jonahdeclerck/swashplateless_helicopter/README.md

A Swashplateless Helicopter Design Inspired by [this video by Tom Stanton](https://youtu.be/d80oXSCcHTk?si=MYQpmtHN8eGi8ZL7) 

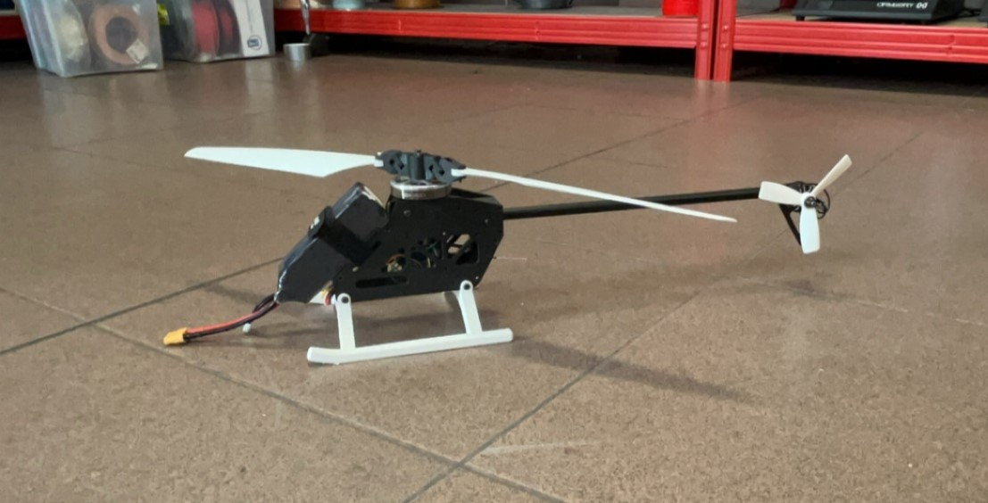
[picture p1: img/swashplateless.jpg]
swashplateless helicopter
