jonahdeclerck/swashplateless_helicopter/3d-files/rotorhead/v4/arm.stl

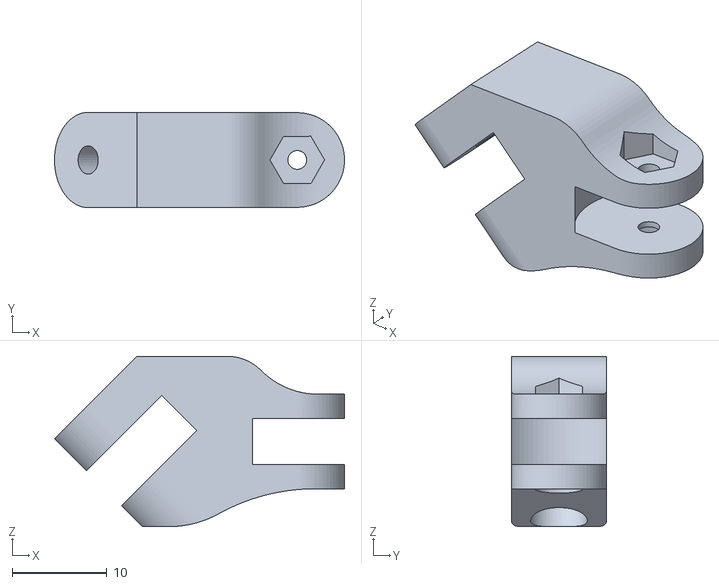
[picture p31: CAD file, 2024-05-28]
3d-files/rotorhead/v4/arm.stl
30.6 x 10.0 x 18.0
