jonahdeclerck/swashplateless_helicopter/3d-files/side-plate-v2.stl

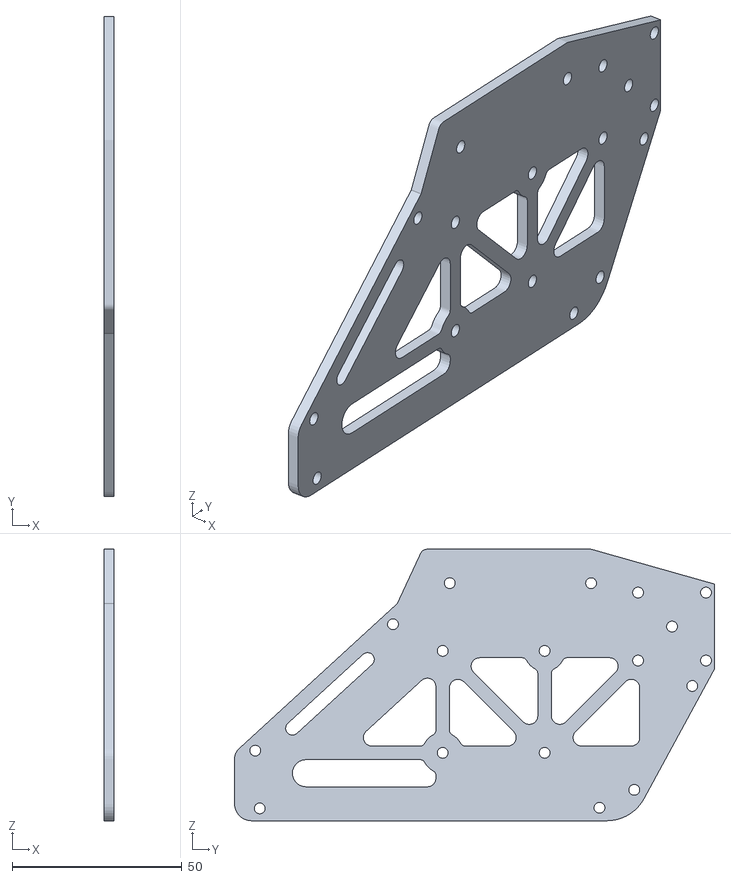
[picture p32: CAD file, 2024-05-28]
3d-files/side-plate-v2.stl
3.00 x 141.3 x 79.9
