jonahdeclerck/swashplateless_helicopter/3d-files/stack-mount/stack-mount-v2.stl

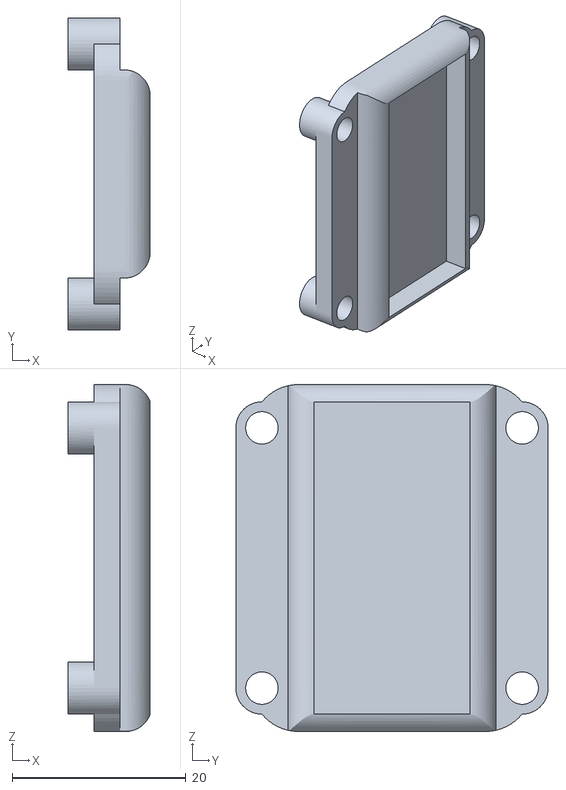
[picture p33: CAD file, 2024-05-28]
3d-files/stack-mount/stack-mount-v2.stl
9.50 x 36.0 x 40.0
