jonahdeclerck/swashplateless_helicopter/3d-files/tailboom/tailboom-block/tailboom-block-v2.stl

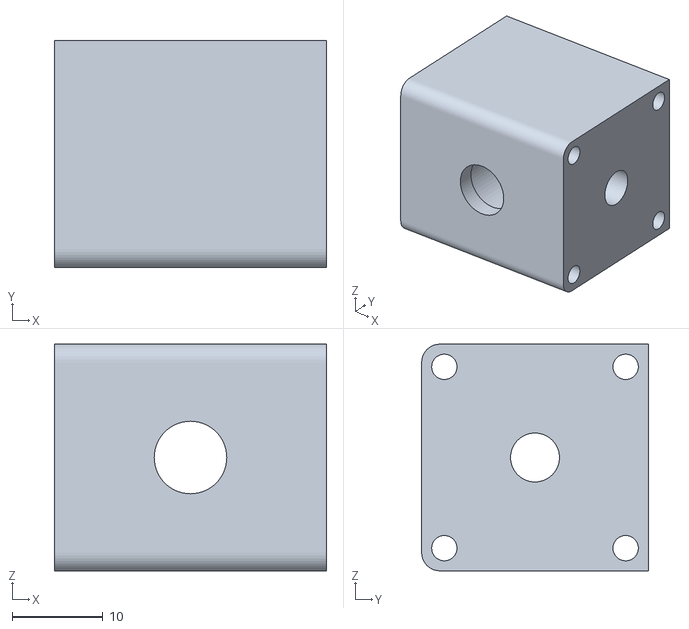
[picture p34: CAD file, 2024-05-28]
3d-files/tailboom/tailboom-block/tailboom-block-v2.stl
30.0 x 25.0 x 25.0
