jonahdeclerck/swashplateless_helicopter/3d-files/tailboom/tailboom-motor-mount/v3/tailboom-motor-mount-v3.stl

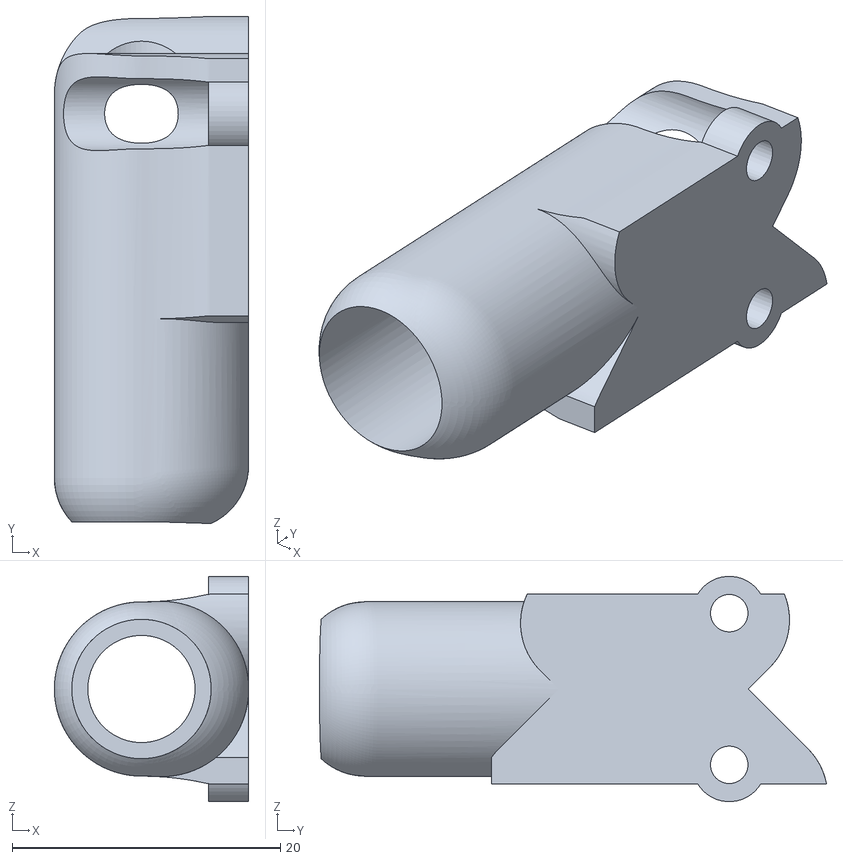
[picture p35: CAD file, 2024-05-28]
3d-files/tailboom/tailboom-motor-mount/v3/tailboom-motor-mount-v3.stl
14.5 x 37.8 x 16.8
