jonahdeclerck/swashplateless_helicopter/3d-files/top-plate/v5/top.stl

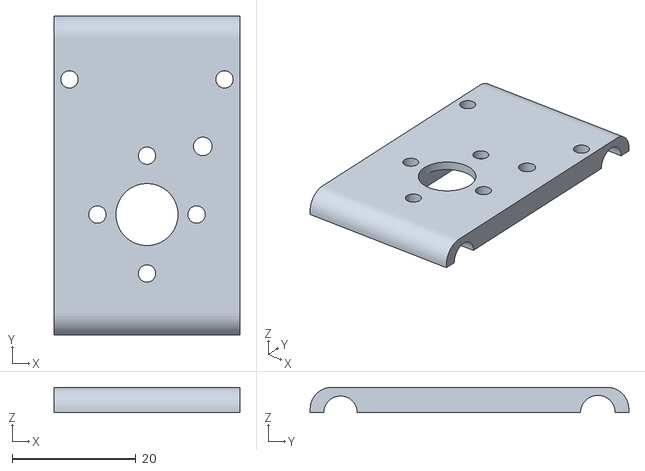
[picture p36: CAD file, 2024-05-28]
3d-files/top-plate/v5/top.stl
30.0 x 51.4 x 4.10
