jonahdeclerck/swashplateless_helicopter/3d-files/rotorhead/v5 (bearings)/hub.stl

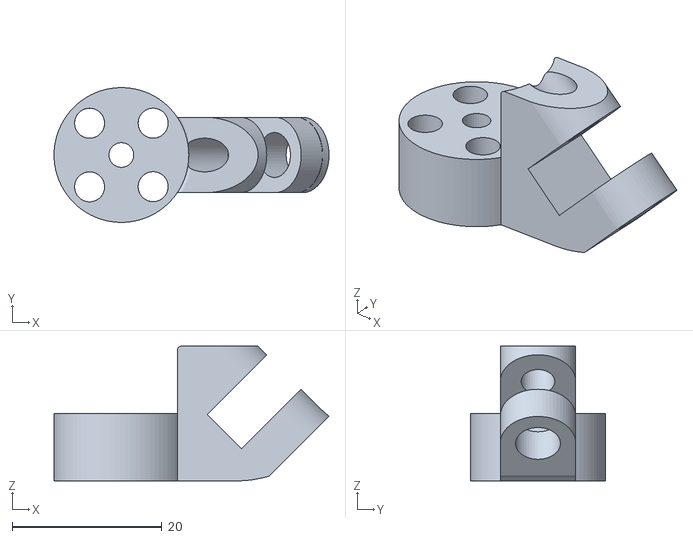
[picture p37: CAD file, 2024-05-28]
3d-files/rotorhead/v5 (bearings)/hub.stl
36.7 x 18.0 x 18.0
