jonahdeclerck/swashplateless_helicopter/3d-files/top-plate/v5/bottom.stl

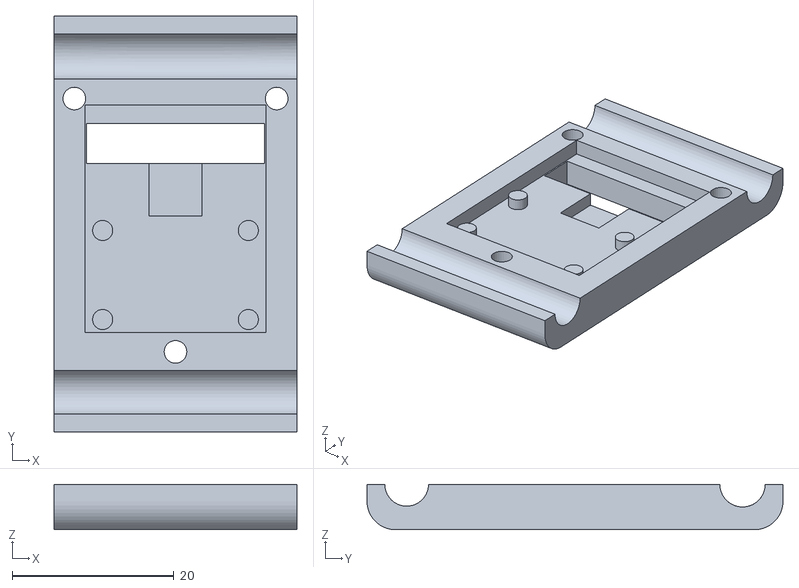
[picture p38: CAD file, 2024-05-28]
3d-files/top-plate/v5/bottom.stl
30.0 x 51.4 x 5.60
