jonahdeclerck/swashplateless_helicopter/3d-files/skids-v1.stl

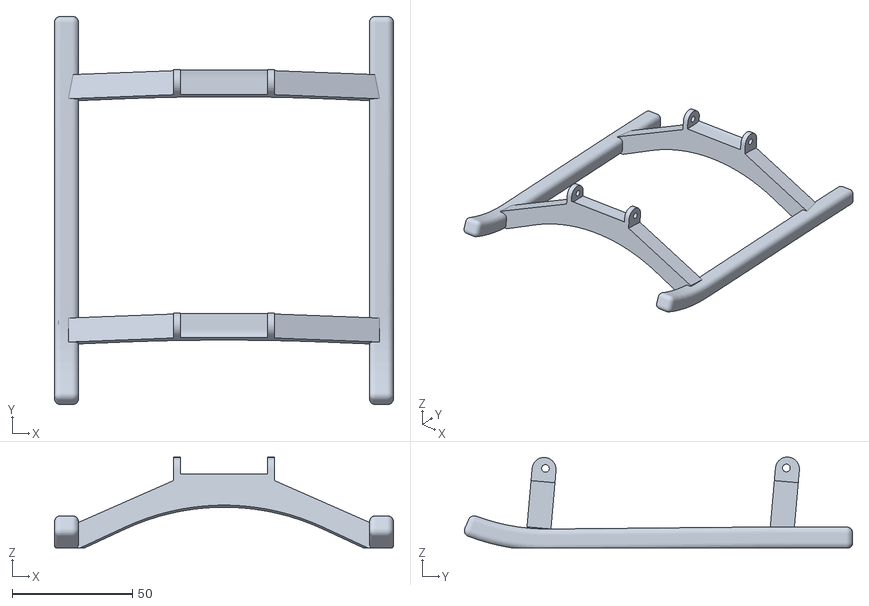
[picture p39: CAD file, 2024-05-28]
3d-files/skids-v1.stl
140.7 x 161.2 x 37.7
