jonahdeclerck/swashplateless_helicopter/3d-files/rear-plate-v1.stl

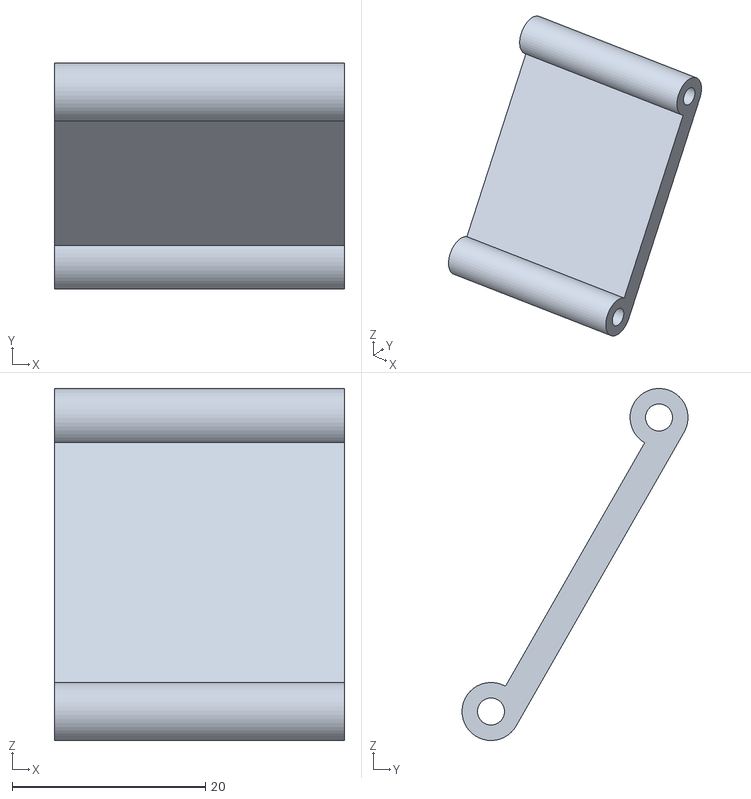
[picture p40: CAD file, 2024-05-28]
3d-files/rear-plate-v1.stl
30.0 x 23.4 x 36.4
