jonahdeclerck/swashplateless_helicopter/3d-files/bottom-plate-v1.stl

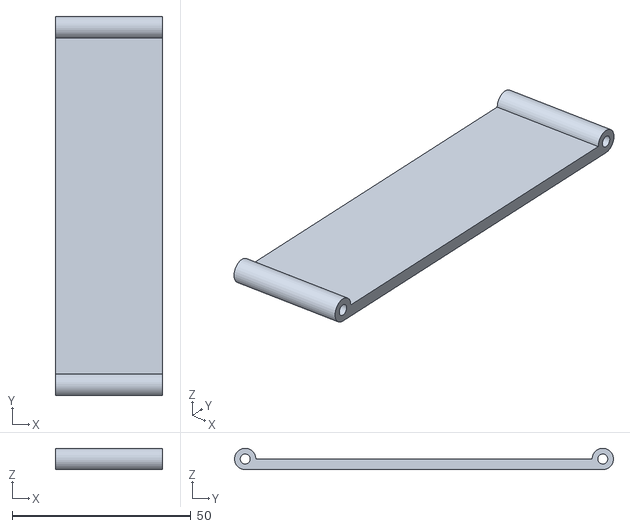
[picture p41: CAD file, 2024-05-28]
3d-files/bottom-plate-v1.stl
30.0 x 106.0 x 5.99
