jonahdeclerck/swashplateless_helicopter/3d-files/front-plate-v4.stl

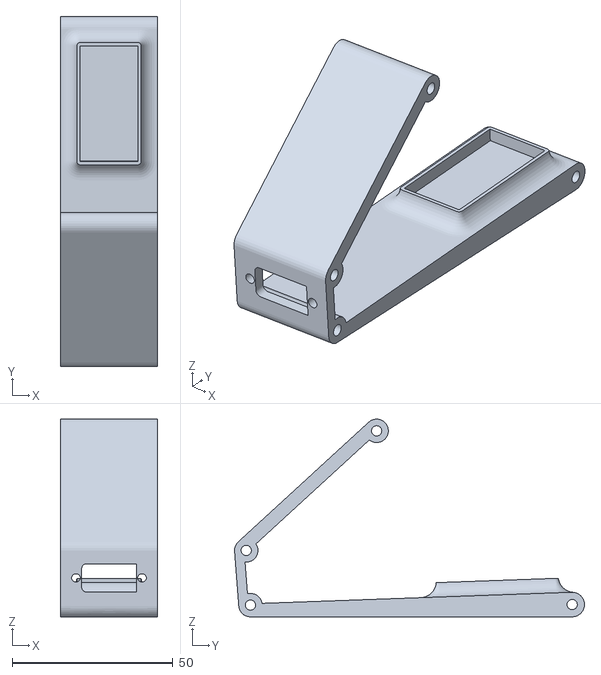
[picture p42: CAD file, 2024-05-28]
3d-files/front-plate-v4.stl
30.0 x 108.8 x 61.5
