jonahdeclerck/swashplateless_helicopter/3d-files/rear-plate-v2-tracer_rx.stl

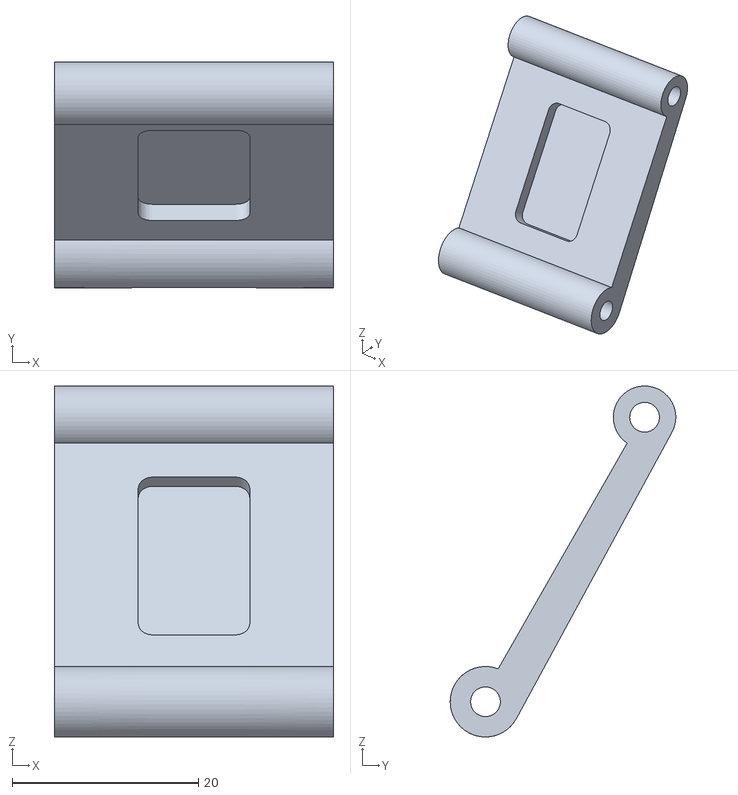
[picture p43: CAD file, 2024-05-28]
3d-files/rear-plate-v2-tracer_rx.stl
30.0 x 24.2 x 37.7
