jonahdeclerck/swashplateless_helicopter/3d-files/rotorhead/v1/hub.stl

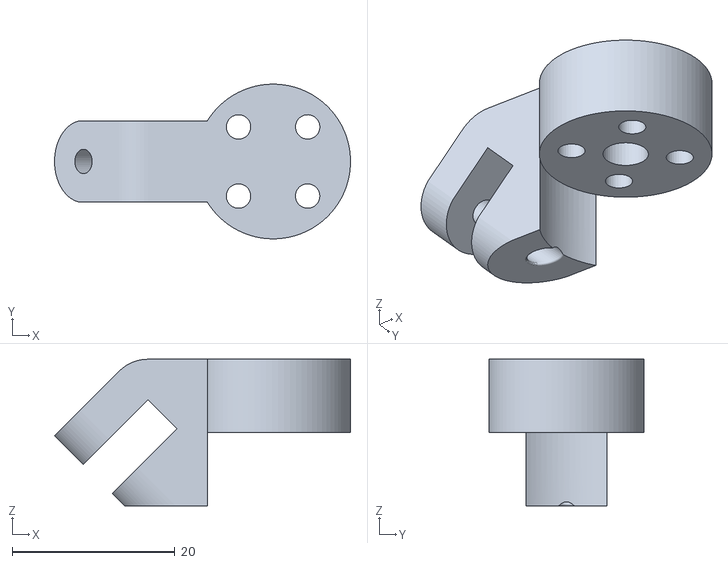
[picture p44: CAD file, 2024-05-28, an earlier design]
3d-files/rotorhead/v1/hub.stl
36.3 x 19.0 x 18.0
