jonahdeclerck/swashplateless_helicopter/3d-files/rotorhead/v2/hub.stl

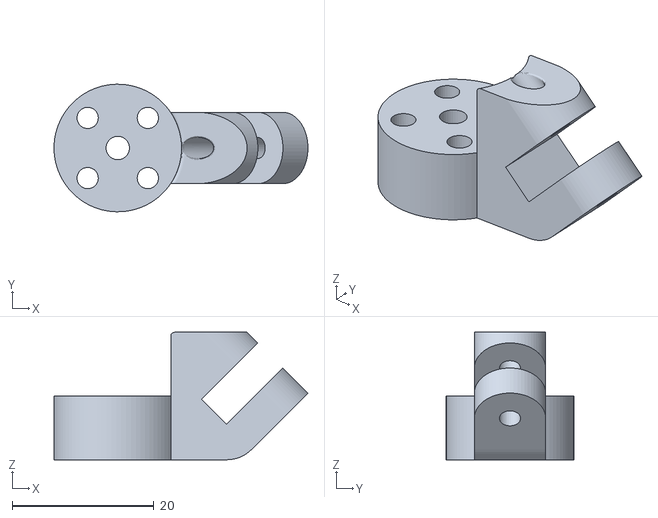
[picture p45: CAD file, 2024-05-28, an earlier design]
3d-files/rotorhead/v2/hub.stl
35.8 x 18.0 x 18.0
