jonahdeclerck/swashplateless_helicopter/(list of files, cad)

Other CAD files:
3d-files/rotorhead/v5 (bearings)/arm.stl
3d-files/front-plate-v2-9v_bec.stl
3d-files/front-plate-v1.stl
3d-files/front-plate-v3.stl
3d-files/rotorhead/v1/hub_insert.stl
3d-files/rotorhead/v2/arm.stl
3d-files/rotorhead/v3/arm.stl
3d-files/side-plate-v1.stl
3d-files/stack-mount/stack-mount-v1.stl
3d-files/tailboom/tailboom-block/tailboom-block-v1.stl
3d-files/tailboom/tailboom-motor-mount/v1/tailboom-motor-mount-v1.stl
3d-files/tailboom/tailboom-motor-mount/v2/tailboom-fin-v1.stl
3d-files/tailboom/tailboom-motor-mount/v2/tailboom-motor-mount-v2.stl
3d-files/top-plate/v1/bottom.stl
3d-files/top-plate/v1/top.stl
3d-files/top-plate/v2/bottom.stl
3d-files/top-plate/v2/top.stl
3d-files/top-plate/v3/bottom.stl
3d-files/top-plate/v3/top.stl
3d-files/top-plate/v4/bottom.stl
3d-files/top-plate/v4/top.stl
