jonahdeclerck/swashplateless_helicopter/(commit log)

2024-04-26 changed folder name for arduino upload, added as5047p function, added custom IMU orientation
2024-05-03 removed loopblink to avoid duplicate use of pin 13, added third channel check for arming to prevent arm on no rx detected
    [dRehmFlight_Teensy_BETA_1.3.ino]
2024-05-07 set up bidirectional tailmotor, fixed arming parameters
    [code.ino]
2024-05-13 switched m1 to pwm instead of oneshot125
2024-05-18 Refactor servo commands for better readability and maintainability
2024-05-21 removed unused magnetometer functionality and variables
2024-05-28 added 3d models
    [arm.stl, bottom-plate-v1.stl, bottom.stl, front-plate-v1.stl, front-plate-v2-9v_bec.stl, front-plate-v3.stl, front-plate-v4.stl, hub.stl]
2024-05-28 updated tailrotor control mixer to counteract main rotor yaw effect
2024-07-04 chore: Remove unused magnetometer functionality and variables
